ZeniteSolar/Chopper2016/README.md

# Chopper2016
Repositório dedicado ao desenvolvimento do Chopper2016
