ZeniteSolar/Chopper2016/Snubber/A non isolated bidirectional DC-DC converter with LCD snubber.pdf

Rev. Téc. Ing. Univ. Zulia. Vol. 39, Nº 1, 131 - 143, 2016

## A non isolated bidirectional DC-DC converter with LCD snubber

J.Barsana Banu¹

, Dr.M.Balasingh Moses²

and S.Rajarajacholan³
1Research Scholar,EEE Dept, Anna University, Trichy,India. 2Assistant Professor,EEE Dept, Anna University, Trichy, India. 3Teaching Fellow,EEE Dept, University College of Engineering,Ariyalur, India. *Correspondence:barsanajamal@gmail.com

Abstract: This paper proposes a non isolated Bidirectional DC-DC Converter with LCD (Inductance Capacitance Diode) snubber achieves high efficiency. In this paper non dissipative LCD clamp circuit is introduced not only achieves high efficiency, reduces cost, simple structure and also reduces current spike in the conventional NBDC, reduces switching losses and applicable for higher power conversion. The proposed non dissipative LCD snubber recycle the energy absorbed from either input or output side and it circulate through throughout the switching period. The proposed topology is simulated using MATLAB/SIMULINK software and its operation modes for both boost and buck conversion has been investigated
throughout the paper. The simulated results of the proposed converter are compared with the conventional NBDC’s
topologies to verify its effectiveness. The proposed NBDC topology is experimentally verified for a 0.5 KW prototype.
Key words: LCD Snubber, Non isolated bidirectional dc-dc converter (NBDC), soft switching, current spike.

### 1. INTRODUCTION

The Bidirectional DC-DC Converter topologies has raised lot of attention in recent years for the application of many power related system including fuel cell, hybrid electric vehicle ,renewable energy system, Uninterruptable power supplies and so on which needs high efficiency and high power density. The Bidirectional DC-DC Converter transfer power between its input and output power sources by step up or step down the voltage levels depending upon the requirements. Basically bidirectional DC-DC converters can be classified in to Non Isolated bidirectional DC-DC converters and isolated bidirectional DC-DC converters.
In Isolated bidirectional DC-DC converters galvanic isolation is needed between current fed and voltage fed bridges. High frequency isolation transformer provided in the full bridge topologies increases cost and number of switching devices ( Inoue.S et al.,2007, Lizhi Zhu ,2006, and T.Reimann et al.,1997).Dual active bridge isolated bidirectional are proposed to raise the power level with different phase shift control (Huiqing Wen et al.,2015,Krismer F et al.,2009,Mi.C et al.,2008, and R.W. De Doncker et al.,2007).Isolated bidirectional dc-dc converter with RCD snubber,flyback, active clamp and passive clamp methods are also described to improve the conversion ratio ,reduction of voltage spike, limiting voltage and current stresses through the active switches and soft switching achieved (Mohammadjavad Baei et al.,2014,R.Watson et al., 1996, Tsai-Fu-Wu et al.,2010, Tsai-Fu Wu et al.,2011,and Yanbo Che et al.,2014). Sometimes bidirectional power flow between grid and battery is possible (Ho-Sung Kim et al., 2013, and Hua Han et al., 2014).
Due to weight, size, high number of semiconductor devices and power transformer associated in the isolated bidirectional dc-dc converter ,the interest is focused to transformer less non-isolated bidirectional DC-DC converter which is attractive converter topology for improving the efficiency .The basic transformer less non-isolated bidirectional DC-DC converter is the combination of boost and buck converter connected in antiparallel.The comparative evaluation of various NBDC based on their efficiencies and cost consideration have done in (Baburaja.C et al.,2013,and Taewon Kang et al.,2012).In the high power converters to achieve maximum efficiency MOSFETS can be applied instead of IGBT with bidirectional power flow legs which suppress the switching loss occurs due to reverse recovery of the body diode (Hyung-Min Ryu .,2014).
To improve the power rating as well as clamp the diode oscillations of the converter RC-RCD clamp circuit is introduced (Milanovic.M et al.,2006).Optimal design of DC-DC converter employed with genetic algorithm and taguchi method are proposed for spike voltage reduction (Chuan-Kuei Huang et al.,2010).To reduce the ripple current shown in the conventional NBDC multiphase interleaved half bridge topology is introduced (Yanbo Che et al.,2014).Due to the low ripple current and reverse recovery problem in the conventional NBDC, series resonance, parallel resonance, and quasi-resonance methods have progressed to alleviate the above problem (K. H. Liu et al.,1987,and R. Redl et al.,1986).Due to high circulating energy conduction losses are occur in the resonant converter, the zero voltage transition (ZVT) and zero current transition (ZCT) methods are introduced to overcome the problems in the resonant converter (G. Hua et al.,1994).
The ZVT and ZCT methods are that switches turning ON and turning OFF under zero voltage and zero current condition using resonance. Sometimes auxiliary switches are used in addition with main switches to operate the NBDC without switching loss (D.-Y. Lee et al.,2003).Zero Voltage transition PWM NBDC are implemented with coupled inductor to achieve high efficiency at both step up and step down conversion (Ju-Kyoung Eom et al.,2012).Leakage inductance is fully utilized and voltage stress in the switches reduced by providing tapped inductor topology(Amin Mirzaei et al.,2012,and Jeong-il Kang et al.,2014).
Modified PWM based NBDCs with coupled inductor is presented to reduce the converter volume (A.Amalin Rishma et al.,2012).Further soft switching NBDC with LC Series resonant circuit is also proposed to achieve maximum efficiency at all load conditions (Doo-Yong Jung et al.,2013).Soft-switching dc-dc converter with auxiliary switch control is proposed to improve the efficiency of non isolated bidirectional converter with look up table reference (Jung-Hyo Lee et al.,2013) this method brings the more efficient control in both step up and step down mode operation.
In this paper non dissipative LCD clamp circuit is introduced to achieve high efficiency, reduces switching losses and applicable for higher power conversion. This Non dissipative LCD snubber recycle the energy absorbed from either input or output side and it circulate through throughout the switching period. The advantages of the proposed converter are high reliability, simple structure, low cost and high efficiency.

### 2. PROPOSED TOPOLOGY

The proposed non isolated bidirectional dc–dc converter with LCD snubber is shown in Fig.1. The proposed LCD snubber circuit consists of Resonant inductor Lr, Resonant Capacitors Cr1 and Cr2 , and two Diodes D1 and D2 in addition with basic bidirectional converter topology. RCD snubber is a dissipative one which dissipate large amount of energy stored in the capacitor through the snubber resistance. Hence it increases the component sizes and creates a heat transfer problems. The proposed non dissipative LCD clamp with passive components eliminates the above problems by storing the leakage energy in to a capacitor even the semiconductor device is in OFF conditions. The proposed converter reduces switching losses with the help of soft switching. The proposed converter is categorized in to two modes: boost mode conversion (step up) and buck mode conversion (step down) based on the current flowing through each component in a proposed circuit and voltage across the switches.

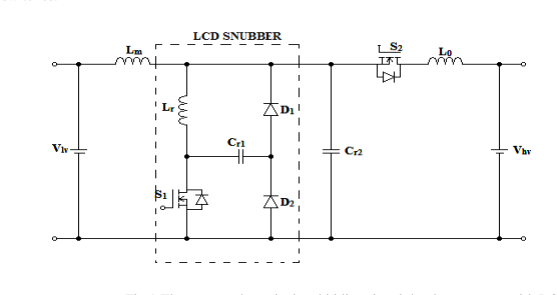
[picture p9: figure]

Fig.1.The proposed non isolated bidirectional dc–dc converter with LCD snubber

Fig.1 consists of main inductor Lm, two main switches S1 and S2 are operated under soft switching. The output inductor L0 perform filtering when energy flows from the input side (low voltage side) to the batteries (high voltage side), which is denoted as a boost mode and vice versa operation takes place in buck mode when power flows from the batteries(high voltage side) to the low voltage side. The resonance of the proposed converter is caused by the main inductor Lm and snubber capacitors Cr1 and Cr2. The proposed LCD clamp recycle the energy absorbed from either input or output side and it circulate through throughout the switching period and soft switching can be achieved .
A non isolated bidirectional dc-dc converter with LCD clamp has two types of conversion: boost mode conversion (step up) and buck mode conversion (step down).In boost mode switch S1 controlled and body diode of S2 provide a current path to the load. In buck mode switch S2 controlled and body diode of S1 provide a current path to the load. To intend the converter design, theoretical investigation must be indomitable. The main aim of the steady state analysis is to obtain derivations and equations for various devices used in the proposed bidirectional LCD clamp circuit.The assumptions are
1) Main inductor Lm is considered large enough
2) All devices are ideal
3) All the elements have zero voltage drops.
In boost mode switch S1 is operated, body diode of switch S2 will conduct to transfer power from low voltage side to high voltage side. In this mode snubber capacitor Cs makes the switchS1 to turn OFF under ZVS.The operation mode of proposed topology in boost mode is divided in to eight modes. Fig. 2 shows the various operation mode of the proposed converter in step up conversion during a switching period.
Mode 1 [ t0 ≤ t < t1 ]: At time t0 switches S1 and S2 are in off state .The input dc voltage is directly connected to the load through main inductor current iLm and antiparallel diode of switch S2. Here the voltage across Lm is negative. Hence iLm decreases linearly.

iLm t0

=

Vlv −Vhv
Lm

t −t0

+ I0

(1)
iLm t1
= I1 = Imin | (2)
iLr

t0

= 0 | (3)
VCr1
t = 0 | (4)
VCr2
t = Vhv = Vco | (5)

Mode 2 [ t1 ≤ t < t2 ]: Mode 1 starts when the switch S1 is turned ON by ZCS because of Lr

.output voltage is
supplied via resonant inductor, thus iLr

starts increasing. The current through the antiparallel diode of switch S2 becomes zero when iLr = iLm
iLm t =

Vlv −Vhv
Lm
t + Imin | (6)
iLm t2
= I1 = Imin | (7)
iLr

t2

= I1

(8)
VCr1
t = 0 | (9)
VCr2
t = Vhv = Vco | (10)

Mode 3 [ t2 ≤ t < t3 ]: This mode is started when current through the antiparallel diode of switch S2 becomes zero. In this mode main inductor current iLm flows through Lr and switch S1.the resonant inductor Lr and the resonant capacitor Cr2 starts resonate, therefore VCr2 starts decreases from output voltage to zero.
iLm t3
= I1 = Imin | (11)
iLr

t = I1 +

Vhv
Lr
t | (12)
iLr

t3

= I2

(13)
VCr1
t = 0 | (14)
VCr2

t = Vco cosωr

t | (15)
ωr =

1
CrLr

(16)

Cr = Cr1 + Cr2

(17)
VCr2

t3

= 0 | (18)

Mode 4 [ t3 ≤ t < t4 ]: This mode begins at VCr2 =0 and the snubber diodes D1 and D2 are turned on. iLm t =

Vlv
Lm

t + I2

(19)

iLm t4

=

Vlv
Lm

t +I2

(20)

iLr

t4

= Imin +

VC 0
Zr

(21)
VCr1
t = 0 | (22)
VCr2
t = 0 | (23)

Mode 5 [ t4 ≤ t < t5 ]: At time t4 ,the switch S1is turned OFF with ZVS condition because of resonant capacitor Vcr1.the proposed circuit serves two current loops in this mode .
i) Lm-Cr2-VLV, VCr2 increases from zero to output voltage
ii) Lr-Cr1- D1, loop for second resonance,energy stored in resonant inductor shifts to Cr1,therefore iLr starts decreasing and VCr1 becomes high value.
iLm t5

= I3

(24)
iLr

t5

= I2 cos ωr

t | (25)

VCr1

t =

Lr
Cr

I2 sinωr1

t | (26)

ωr1 =

1

Cr1Lr

(27)

VCr2

t =

I3

Cr1

(28)
VCr2

t5

= Vhv = Vc0

(29)

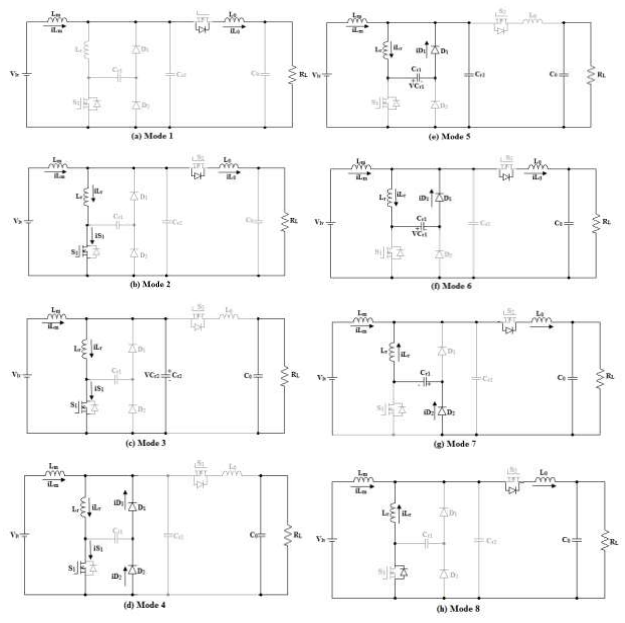
[picture p10: figure]

Fig.2.Operation modes of boost mode conversion (a) Mode 1 (b) Mode 2 (c) Mode 3 (d) Mode 4
(e) Mode 5 (f) Mode 6 (g) Mode 7 (h) Mode 8.

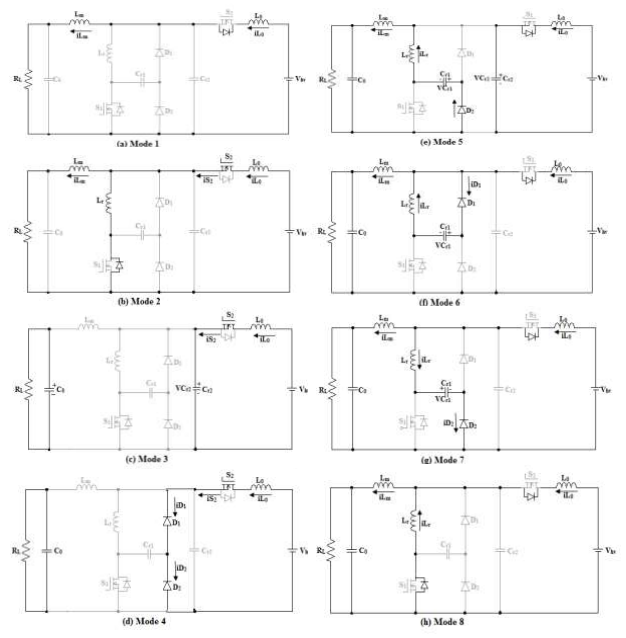
[picture p11: figure]

Fig.3.Operation modes of buck mode conversion (a) Mode 1 (b) Mode 2 (c) Mode 3 (d) Mode 4
(e) Mode 5 (f) Mode 6 (g) Mode 7 (h) Mode 8.

Mode 6 [ t5 ≤ t < t6 ]: This mode starts at VCr1 =V0 and iLr =0 because of energy stored in resonant inductor is totally discharged to VCr1.
iLm t5
= I4 = Imax | (30)
iLr

t6

= 0 | (31)

VCr1

t =

Lr
Cr

I2 cos ωr1

t | (32)

VCr1

t6

= 0 | (33)
VCr2
t = Vhv = Vc0 | (34)

Mode 7 [ t6 ≤ t < t7 ]:In this mode VCr1 starts resonate and decreases through D2 - Cr1- Lr-Ds2- C0 untilVCr1 =0 ,the energy absorbed in Cr1discharges to resonant inductor Lr

.when VCr1 =0, iLr changes its current direction,then antiparallel diode of switch S2 turns on.
iLm t =
Vlv −Vhv Lm t + I4 | (35)

iLm t7

= I5

(36)
iLr

t = I2 sinωr

t | (37)
iLr

t7

= 0 | (38)

VCr1

t = Vc0 −

Lr
Cr

I2 cosωr1

t | (39)

VCr1

t7

= 0 | (40)
VCr2
t = Vc0 | (41)

Mode 8 [ t7 ≤ t < t8 ]: This mode begins at VCr1 =0.It has two current paths.The main inductor current flows to the load through antiparallel diode of switch S2 as well as resonant inductor current shifts to the load through
Ds1 and Ds2.This mode ends at iLr reaches to zero. iLm t8 = I6 | (42)

iLr

t = I5 −

Vc0
Lr
t | (43)
iLr

t8

= 0 | (44)
VCr1
t = 0 | (45)
VCr2
t = Vhv = Vc0 | (46)

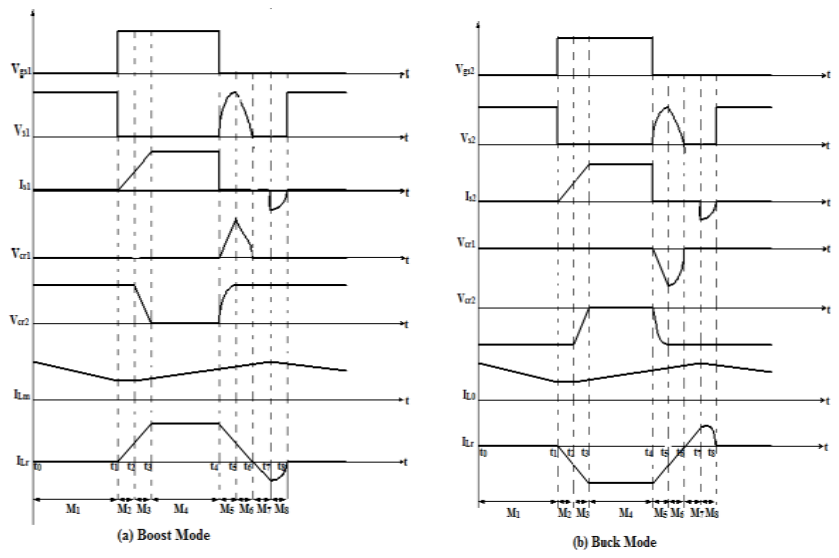
[picture p12: figure]

Fig.4.Key waveforms (a) Boost Mode (b) Buck Mode

Fig.3 shows the operation mode of the proposed converter in step down conversion during a switching period. Key waveforms for boost mode and buck mode is described in Fig.4.In buck mode switch S2 is operated and body diode of switch S1 will conduct to transfer power from high voltage side to batteries (low voltage side). In this mode snubber capacitor Cs makes the switch S2 to turn OFF under ZVS.The operation mode of proposed topology in buck mode is analogous to the boost mode and also divided in to eight modes as indicated in fig 3 because it operates in inverse with boost mode.

### 3. RESULTS AND DISCUSSIONS

In order to verify the feasibility of the proposed LCD snubber topology. A 0.5 KW converter prototype was built and implemented. MATLAB/SIMULINK software is used to simulate the proposed non isolated bidirectional dc-dc converter with LCD clamp circuit to verify its effectiveness for both buck and boost modes. The switching current and voltages waveforms are measured to ensure the converter is operated in soft switching condition. Fig.5 shows the 0.5 KW prototype of the proposed NBDC with LCD clamp,it should be

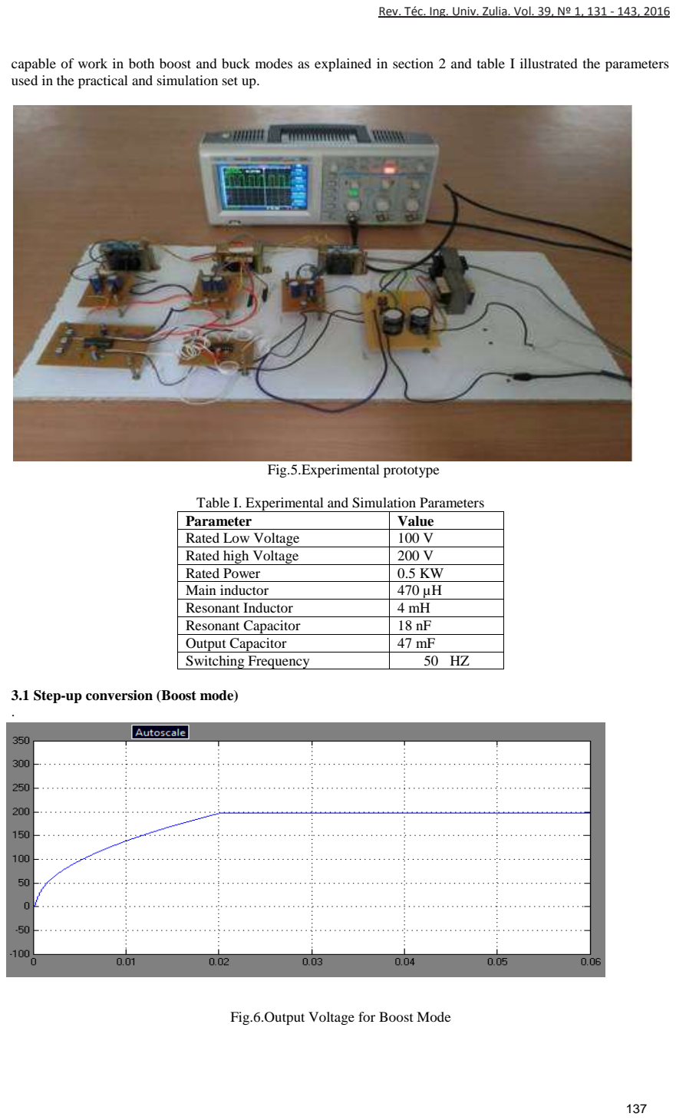
[picture p13: page 7]

capable of work in both boost and buck modes as explained in section 2 and table I illustrated the parameters used in the practical and simulation set up.

Fig.5.Experimental prototype

Table I. Experimental and Simulation Parameters
Parameter | Value
Rated Low Voltage | 100 V
Rated high Voltage | 200 V
Rated Power | 0.5 KW
Main inductor | 470 µH
Resonant Inductor | 4 mH
Resonant Capacitor | 18 nF
Output Capacitor | 47 mF
Switching Frequency | 50 HZ

### 3.1 Step-up conversion (Boost mode)

Fig.6.Output Voltage for Boost Mode

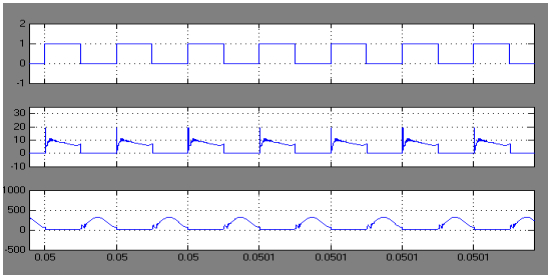
[picture p14: figure]

Fig.7.Triggering pulse, current through and voltage across switch S1

Fig.6 shows the simulated output voltage for boost (200 V) mode with the dc input voltage of 100 V. The gate pulse, current flowing through and voltage across the terminals for switch S1 of the proposed topology is obtained in Fig.7 for step up and 200 V dc for step down conversion. From the above waveforms it is clearly states the switch S1 is operated under zero voltage condition, it is turned ON and OFF at zero voltage ripple current also reduces, and therefore current through the inductor is continuous.

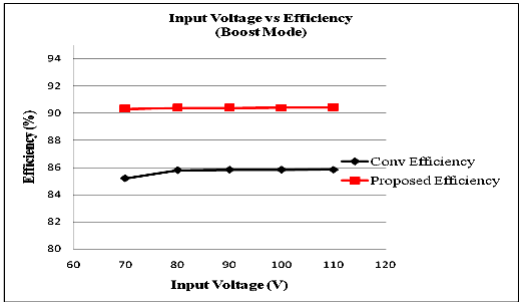
[picture p15: figure]

Fig.8.Efficiency Comparision of boost mode

138

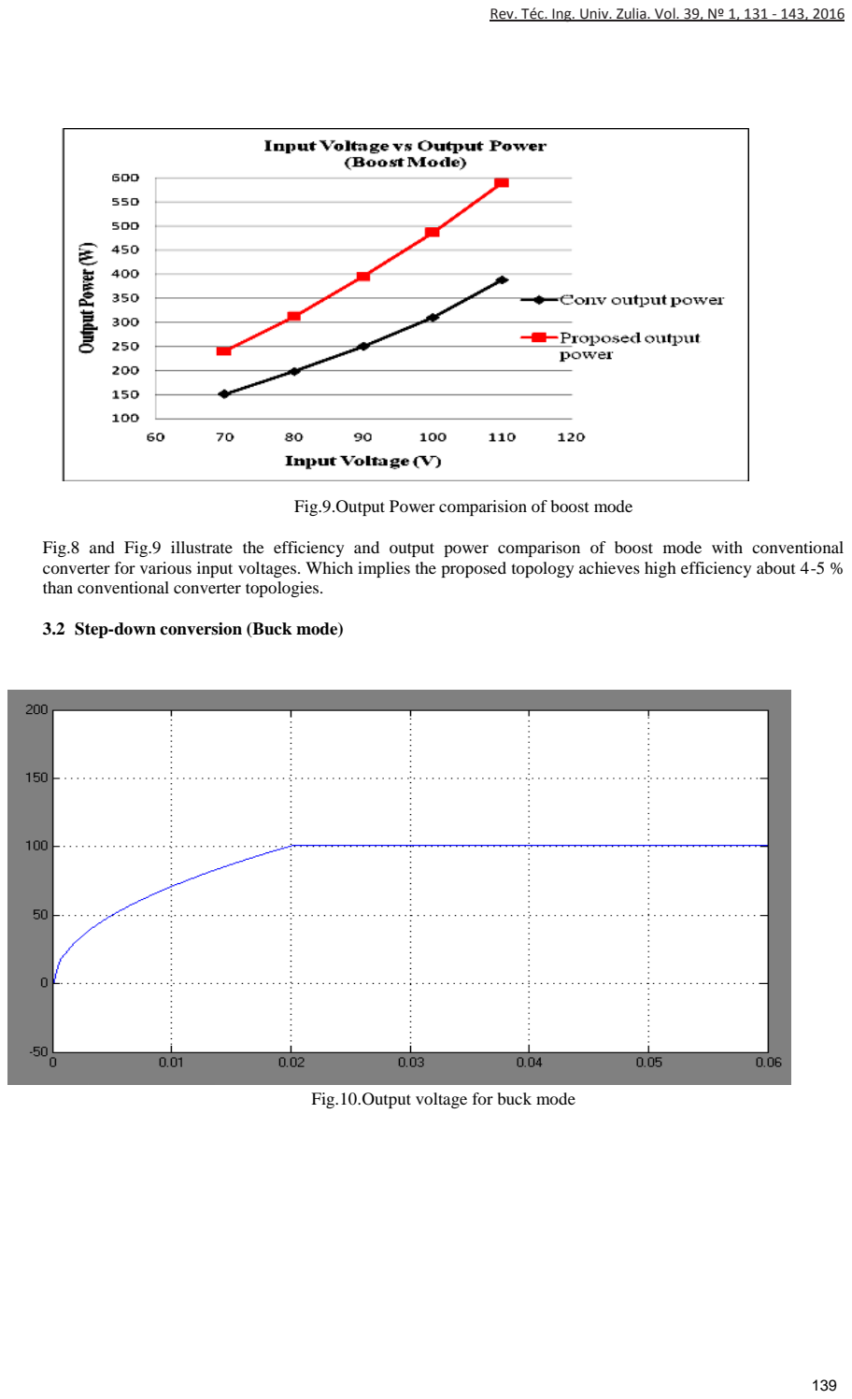
[picture p16: page 9]

Fig.9.Output Power comparision of boost mode

Fig.8 and Fig.9 illustrate the efficiency and output power comparison of boost mode with conventional converter for various input voltages. Which implies the proposed topology achieves high efficiency about 4-5 % than conventional converter topologies.

### 3.2 Step-down conversion (Buck mode)

Fig.10.Output voltage for buck mode

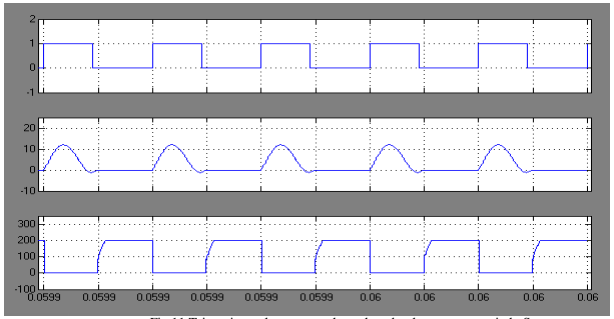
[picture p17: figure]

Fig.11.Triggering pulse, current through and voltage across switch S2

Fig.10 shows the simulated output voltage for buck (100 V) mode. Fig.11 shows the gate pulse, current through and voltage across waveforms for switch S2 of the proposed NBDC when the input voltage is 200 V dc for step down conversion. From the above waveforms it is obviously the switches are operated under zero voltage condition during buck mode, ripple current also reduces, and therefore current through the inductor is continuous as same as boost mode.

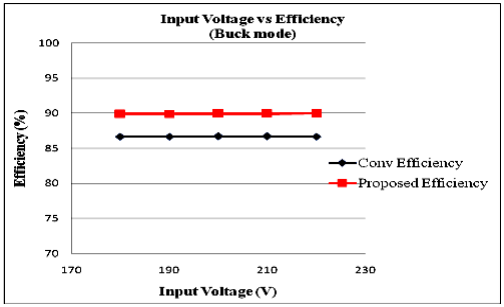
[picture p18: figure]

Fig.12.Efficiency Comparision of buck mode

140

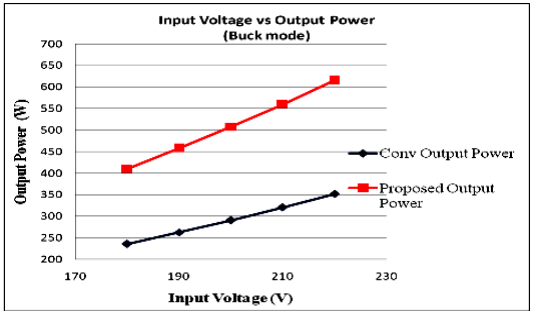
[picture p19: figure]

Fig.13.Output Power Comparison of buck mode

The efficiency and output power comparison of buck mode is done in Fig.12 and Fig.13.which also states that the proposed topology achieves high efficiency than conventional NBDC.

Table II. Efficiency comparison of the proposed converter operation
Switching | Boost mode | Buck mode
Input voltage(V) | Output power(W) | Efficiency (%η) | Input voltage(V) | Output power(W) | Efficiency (%η)
Hard | 70 | 151 | 85.2 | 180 | 236 | 86.67
Soft | | 240 | 90.3 | | 410 | 89.89
Hard | 80 | 198 | 85.79 | 190 | 263 | 86.68
Soft | | 312 | 90.37 | | 458 | 89.91
Hard | 90 | 250 | 85.42 | 200 | 291 | 86.7
Soft | | 395 | 90.38 | | 508 | 89.93
Hard | 100 | 310 | 85.83 | 210 | 321 | 86.72
Soft | | 487 | 90.39 | | 560 | 89.94
Hard | 110 | 388 | 85.84 | 220 | 352 | 86.69
Soft | | 580 | 90.41 | | 616 | 89.96

Table II indicate the output power and efficiency comparison of conventional hard switching NBDC and proposed NBDC with LCD clamp. The proposed circuit achieves high efficiency for the same input voltage applied at all modes.

### 4. CONCLUSIONS

This paper presents a non isolated bidirectional dc-dc converter with LCD clamp circuit that is specifically used for battery applications that require a maximum efficiency is proposed in this paper for step up and step down conversion. The proposed Non dissipative LCD snubber recycle the energy absorbed from either input or output side and it circulate through throughout the switching period as well as reduces the current ripple and switching losses with proper operation of the switches. Soft switching capability is achieved at all operating modes. The validity of the proposed topology is experimentally verified.

References
A.Amalin Rishma,P.Raja Rajeswari,M.Sasikumar, “High Efficiency Modified Pulse | Width | Modulation
Bidirectional Converters for Medium Power Drives,”IJAIEM, vol. 1, no. 2, pp. 94–100, 2012.

Amin Mirzaei,Awang jusoh,Zainal Salam, “Design and Implementation of High Efficiency | Non | Isolated
Bidirectional Zero Voltage Transition Pulse With | modulated | DC-DC | converters,” | 2012,
Elsevier,Energy 47, pp. 358–369.
Baburaja.C | and | J.Jayakumar, | “Transformer | less | soft | switching | bi-directional | DC-DC
Chopper”,International journal of Engineering and Advanced Technology, 2013, | vol. 2, pp.
391-395.
Chuan-Kuei Huang,Hsiau-Hsian Nien,Koan-Yuh Chang and Wen-Jer Chang,,“An | Optimal | Designed
RCD Snubber for DC-DC Converters,”Journal of Marine | Science and Technology, Vol. 18, No. 6,
pp. 901-906, 2010
D.-Y. Lee, M.-K. Kee, D.-S. Hyun, and I. Choy, “New zero-current-transition PWM | DC/DC | converters
without Current Stress,” IEEE Trans. Power Electron., 2003,vol. 18, no. 1, pp. 95–104.
Doo-Yong Jung, Sun-Hee Hwang, Young-Hyok Ji, Jung-Hyo Lee, Yong-Chae Jung and Chung-Yuen | Won,
“Soft-Switching Bidirectional dc-dc Converter with a LC | Series Resonant Circuit,” IEEE Trans.
Power Electron ,vol. 28, no. 4, pp. 1680– | 1690,2013.
G. Hua, C. Leu, Y. Jiang, and F. C. Lee, “Novel zero-voltage transition PWM converters,” | IEEE | Trans.
Power Electron., vol. 9, no. 2, pp. 213– 219, Mar. | 1994.
Ho-Sung Kim,Myung-Hyo Ryu,Ju-Won Back and Jee-Hoon Jung, “High-Efficiency | Isolated Bidirectional
AC-DC Converter for a dc Distribution System,” IEEE Trans.Power Electron., 2013, vol. 28, no. 4, pp. 1642–1654.
Hua Han,Yonglu Liu,Yao Sun,Hui Wang and Mei Su, “A Single Phase Current Source Bidirectional Converter for V2G Applications” Journal of Power Electronics, 2014,vol. 14, no. 3, pp. 458-467.
Huiqing Wen and BinSu, “Reactive Power and Soft-Switching Capability Analysis of | Dual -Active –Bridge
DC-DC Converters with Dual-Phase-Shift Control” | Journal of Power Electronics, vol. 15, no. 1, pp.
18–30, 2015
Hyung-Min Ryu , “High Efficient High-Volatge MOSFET Converter with Bidirectional Power Flow Legs”,
Journal of Power Electronics, Vol. 14, No. 2, pp. 265-270, | 2014.
Inoue S. & Akagi.H ,“A Bidirectional dc-dc Converter for an Energy Storage System | with | Galvanic
Isolation,” IEEE Trans. Power Electron., 2007, vol. 22, no. 6, pp. | 2299-2306.
Jeong-il Kang,Sang-Kyoo Han and Jonghee Han, “Lossless Snubber with Minimum | Voltage Stress for
continiousCurrent Mode Tapped-Inductor Boost Converters | for | High | Step-up | Applications,”
2014,Journal of Power Electronics, vol. 18, no. | 4, pp. 621–631.
Ju-Kyoung Eom,Jun-Gu Kim,Jae-Hyung Kim,Soon-Tack oh, “Analysis of a Novel Soft Switching Bidirectional DC-Dc converter,” 2012, vol. 12, no. 6, pp. 859–868.
Jung-Hyo Lee,Dong-Ho Yu,Jun-Gu Kim & Young-Ho Kim,“Auxiliary Switch Control of a Bidirectional SoftSwitching dc-dc Converter,” IEEE Trans. Power Electron, vol. 28, no. 12, pp. 5446–5457, Dec 2013.
K. H. Liu, R. Oruganti, and F. C. Lee,“Quasi-resonant converters-topologies and | characteristics,” IEEE
Trans. Power Electron.,vol. PE-2, no. 1, pp. 62–71,1987.
Krismer F and J. W. Kolar, “Accurate small-signal model for the digital control of an | automotive
bidirectional dual active bridge,” IEEE Trans.Power Electron., 2009, | vol. 24, no.12, pp. 2756–2768.
Lizhi Zhu, “A Novel Soft-Commutating Isolated Boost Full Bridge ZVS PWM dc–dc | Converter | for
Bidirectional High Power Applications,” IEEE Trans.Power | Electron, 2006,vol. 21, no.2, pp. 422-
429.
Mi.C,Bai.H,Wang.C and Gargies.S, “Design and control of dual H-bridge based isolated bidirectional DC-DC
Converter,” IEEE Trans. Power Electron, 2008,vol.1, no 4, pp. 507–517
Milanovic.M,Korelic.J,Hren.A,Mihalic.F and Slibar.P,“ Reduction of Ringing Losses in Flyback Converter by
Using the RC-RCD Clamp Circuit”AUTOMATIKA 47 , | 2006,vol. 1, no. 2, pp. 31-37.
Mohammadjavad Baei, Mehdi Narimani and Gerry Moschopoulos,“A New ZVS-PWM Full-Bridge | Boost
Converter,” Journal of Power Electronics, 2014, Vol. 14, No. | 2, pp. 237-248.
R. Redl, B. Molnar, and N. O. Sokal, “Class E resonant regulated dc/dc power | converters: | Analysis | of
operation and experimental results at 1.5 MHz,” IEEE Trans.Power Electron., 1986,Vol. PE-1, no. 2, pp. 111–120.
R.W. De Doncker, D. M. Divan, and M. H. Kheraluwala, “Power conversion apparatus for dc-dc conversion
using dual active bridges,” OS. Patent No. 5,027,261, 2007.
R.Watson. and F. C. Lee,“A Soft Switched Full Bridge Boost Converter Employing an | Active | Clamp
Circuit,” lEEE Power Electron. Spec. Conf.proc , 1996, vol.2,pp. | 1948-1954.
T. Reimann, S. Szeponik, and G. Berger, “A novel control principle of bi-directional | DC-DC | Power
Conversion,” in Proc. Power Electron. Spec.Conf, 1997, vol. 2, pp. 978–984.
Taewon Kang,Changwoo kim and Yongsug Suh,“A Design and control of Bidirectional Non isolated DC-DC
converter for Rapid Electric Vehicle Charging System”, | 2012, pp. 14–21

Tsai-Fu Wu, Jeng-Gung Yang , Chia-Ling Kuo , Kun-Han Sun , Yu-Kai Chen, “Comparison of Bi-directional Isolated full-bridge Converters with Combinations of Active and Passive Snubbers,” 2011,Proc. IEEE
Power | Electron. Spec. Conf.Proc,pp.127-133.
Tsai-Fu-Wu,Yung-chu chen, Jeng-Gung Yang, Chia-Ling Kuo,“Isolated Bidirectional | Full Bridge dc–dc
Converter with a Flyback Snubber,” IEEE Trans.Power | Electron, | vol.25,no. | 7,pp.1915 | –
1922,2010.
Yanbo Che,Yaga Ma,Shaoyun Ge and Dong Zhu,“Digital Control of Secondary Active Clamp Phase-Shifted Full bridge Converters,” Journal of Power Electronics, 2014, vol. 14, no. 3, pp. 421–431

143
