ZeniteSolar/Chopper2016/relatórios/primeiro_teste_24v/ALL0000/F0000CH2.CSV

Record Length | 2.500000e+03 | -0.002500000000 | 14.80000
Sample Interval | 2.000000e-06 | -0.002498000000 | 15.20000
Trigger Point | 1.250000000000e+03 | -0.002496000000 | 14.80000
 |  | -0.002494000000 | 14.80000
 |  | -0.002492000000 | 14.80000
 |  | -0.002490000000 | 14.80000
Source | CH2 | -0.002488000000 | 14.80000
Vertical Units | V | -0.002486000000 | 14.80000
Vertical Scale | 1.000000e+01 | -0.002484000000 | 14.80000
Vertical Offset | -3.000000e+01 | -0.002482000000 | 15.20000
Horizontal Units | s | -0.002480000000 | 14.80000
Horizontal Scale | 5.000000e-04 | -0.002478000000 | 14.80000
Pt Fmt | Y | -0.002476000000 | 14.80000
Yzero | 0.000000e+00 | -0.002474000000 | 14.80000
Probe Atten | 1.000000e+01 | -0.002472000000 | 14.80000
Model Number | TDS1012C-EDU | -0.002470000000 | 14.80000
Serial Number | C013516 | -0.002468000000 | 14.80000
Firmware Version | FV:v25.07 | -0.002466000000 | 14.80000
 |  | -00.002464000000 | 14.80000
 |  | -00.002462000000 | 14.80000
 |  | -00.002460000000 | 14.80000
 |  | -00.002458000000 | 14.80000
 |  | -00.002456000000 | 14.80000
 |  | -00.002454000000 | 14.80000
 |  | -00.002452000000 | 14.80000
 |  | -00.002450000000 | 15.20000
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
