ZeniteSolar/Chopper2016/relatórios/primeiro_teste_24v/ALL0002/F0002CH1.CSV

Record Length | 2.500000e+03 | -0.000012500000 | 2.08000
Sample Interval | 1.000000e-08 | -0.000012490000 | 2.08000
Trigger Point | 1.250000000000e+03 | -0.000012480000 | 2.08000
 |  | -0.000012470000 | 2.08000
 |  | -0.000012460000 | 2.08000
 |  | -0.000012450000 | 2.08000
Source | CH1 | -0.000012440000 | 2.08000
Vertical Units | V | -0.000012430000 | 2.08000
Vertical Scale | 5.000000e-01 | -0.000012420000 | 2.08000
Vertical Offset | -9.600000e-01 | -0.000012410000 | 2.08000
Horizontal Units | s | -0.000012400000 | 2.08000
Horizontal Scale | 2.500000e-06 | -0.000012390000 | 2.08000
Pt Fmt | Y | -0.000012380000 | 2.08000
Yzero | 0.000000e+00 | -0.000012370000 | 2.08000
Probe Atten | 1.000000e+01 | -0.000012360000 | 2.08000
Model Number | TDS1012C-EDU | -0.000012350000 | 2.08000
Serial Number | C013516 | -0.000012340000 | 2.08000
Firmware Version | FV:v25.07 | -0.000012330000 | 2.08000
 |  | -00.000012320000 | 2.08000
 |  | -00.000012310000 | 2.08000
 |  | -00.000012300000 | 2.08000
 |  | -00.000012290000 | 2.08000
 |  | -00.000012280000 | 2.08000
 |  | -00.000012270000 | 2.08000
 |  | -00.000012260000 | 2.08000
 |  | -00.000012250000 | 2.08000
 |  | -00.000012240000 | 2.08000
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
