ZeniteSolar/Chopper2016/relatórios/primeiro_teste_24v/ALL0003/F0003CH1.CSV

Record Length | 2.500000e+03 | -0.000005000000 | 0.80000
Sample Interval | 1.000000e-08 | -0.000004990000 | 0.80000
Trigger Point | 5.000000000000e+02 | -0.000004980000 | 0.80000
 |  | -0.000004970000 | 0.80000
 |  | -0.000004960000 | 0.80000
 |  | -0.000004950000 | 0.80000
Source | CH1 | -0.000004940000 | 0.40000
Vertical Units | V | -0.000004930000 | 0.80000
Vertical Scale | 1.000000e+01 | -0.000004920000 | 0.80000
Vertical Offset | -1.920000e+01 | -0.000004910000 | 0.40000
Horizontal Units | s | -0.000004900000 | 0.80000
Horizontal Scale | 2.500000e-06 | -0.000004890000 | 0.80000
Pt Fmt | Y | -0.000004880000 | 0.80000
Yzero | 0.000000e+00 | -0.000004870000 | 0.80000
Probe Atten | 1.000000e+01 | -0.000004860000 | 0.80000
Model Number | TDS1012C-EDU | -0.000004850000 | 0.80000
Serial Number | C013516 | -0.000004840000 | 0.80000
Firmware Version | FV:v25.07 | -0.000004830000 | 0.80000
 |  | -00.000004820000 | 0.80000
 |  | -00.000004810000 | 0.40000
 |  | -00.000004800000 | 0.40000
 |  | -00.000004790000 | 0.80000
 |  | -00.000004780000 | 0.80000
 |  | -00.000004770000 | 0.80000
 |  | -00.000004760000 | 0.80000
 |  | -00.000004750000 | 0.40000
 |  | -00.000004740000 | 0.80000
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
