ZeniteSolar/Chopper2016/relatórios/primeiro_teste_24v/ALL0003/F0003CH2.CSV

Record Length | 2.500000e+03 | -0.000005000000 | 15.20000
Sample Interval | 1.000000e-08 | -0.000004990000 | 15.20000
Trigger Point | 5.000000000000e+02 | -0.000004980000 | 15.00000
 |  | -0.000004970000 | 15.00000
 |  | -0.000004960000 | 15.20000
 |  | -0.000004950000 | 15.20000
Source | CH2 | -0.000004940000 | 15.00000
Vertical Units | V | -0.000004930000 | 15.20000
Vertical Scale | 5.000000e+00 | -0.000004920000 | 15.00000
Vertical Offset | -1.500000e+01 | -0.000004910000 | 15.20000
Horizontal Units | s | -0.000004900000 | 15.20000
Horizontal Scale | 2.500000e-06 | -0.000004890000 | 15.20000
Pt Fmt | Y | -0.000004880000 | 15.20000
Yzero | 0.000000e+00 | -0.000004870000 | 15.20000
Probe Atten | 1.000000e+01 | -0.000004860000 | 15.20000
Model Number | TDS1012C-EDU | -0.000004850000 | 15.20000
Serial Number | C013516 | -0.000004840000 | 15.20000
Firmware Version | FV:v25.07 | -0.000004830000 | 15.20000
 |  | -00.000004820000 | 15.20000
 |  | -00.000004810000 | 15.20000
 |  | -00.000004800000 | 15.20000
 |  | -00.000004790000 | 15.20000
 |  | -00.000004780000 | 15.20000
 |  | -00.000004770000 | 15.20000
 |  | -00.000004760000 | 15.20000
 |  | -00.000004750000 | 15.20000
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
