ZeniteSolar/Chopper2016/relatórios/primeiro_teste_24v/ALL0001/F0001TEK.JPG

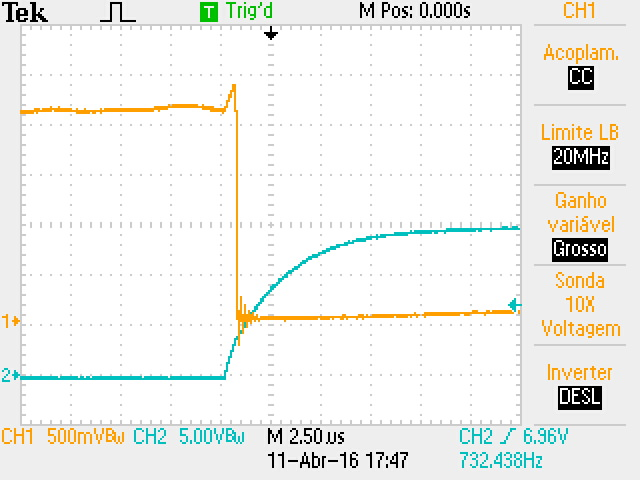
relatórios/primeiro_teste_24v/ALL0001/F0001TEK.JPG
