ZeniteSolar/Chopper2016/relatórios/primeiro_teste_com_carga/TEK0000.JPG

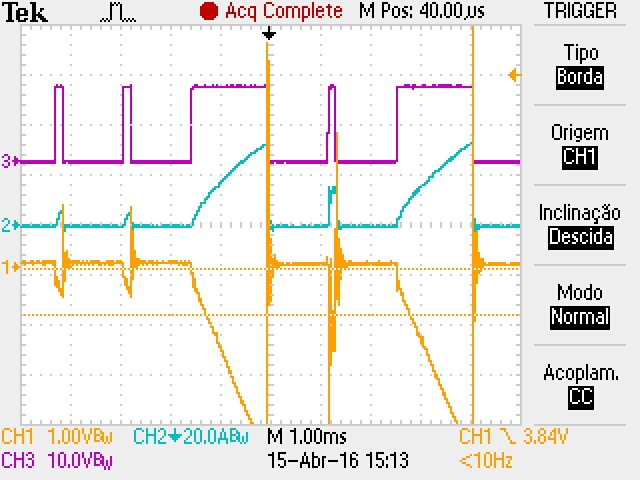
relatórios/primeiro_teste_com_carga/TEK0000.JPG
