ZeniteSolar/Chopper2016/Simulação/LTSPICE/PULSE_LC_.asc

C1: cap; 5480p; Rser=2.3m
L1: ind; 1.66µ
Vin: voltage; PWL(0 0 1u 24)
Named nets: 0, In, out
.tran 0 3u 0 1n
