ZeniteSolar/Chopper2016/Simulação/LTSPICE/SWITCH_LC_.asc

C1: cap; 5480p
C2: cap; 28m; Rser=2 Lser=10n
C3: cap; 5µ2
D1: diode
D2: diode
D3: diode
D4: diode
L1: ind; 38µ
L2: ind; 835n
L3: ind; 835n
L4: ind; 2µ
L7: ind; 20n
L9: ind; 20n
R1: res; 4.8
R2: res; 43m
R3: res; 43m
R4: res; 10
R5: res; 2m
R6: res; 2.3m
R7: res; 2m
S1: sw
V1: voltage; 24
V2: voltage-; 10
Vin: voltage; PULSE(0 10 0 1p 1p .5m 1m)
Named nets: 0, Vds, Vgs, Bat
.tran 0 .7m .49m 10n uic
.model SW SW(Ron=2.3m Roff=1Meg Vt=5)
