ZeniteSolar/Chopper2016/(list of files, drawings)

Other design files:
Hardware/PCB 36V/Chopper PMDC.PcbDoc
Hardware/PCB 36V/Chopper PMDC.PrjPCB
Hardware/PCB 36V/Chopper PMDC.SchDoc
Hardware/PCB 36V/Mosfet_Holes.PcbDoc
Hardware/PCB 36V/PCB1.PcbDoc
Hardware/PCB 36V/PcbLib1.PcbLib
Hardware/PCB 36V/PMDC_power.PcbDoc
Hardware/PCB 36V/Project Outputs for Chopper PMDC/Chopper PMDC.SchDoc
