ZeniteSolar/Chopper2016/Software/placaAdicionalChopper.c

/*
 * Chopper_MPDC_2016.c
 *
 * Created: 18/8/2016 13:25:59
 *  Author: Augusto D. Rodrigues
 *	Equipe Zênite Solar - Projeto Chopper MPDC 2016
 */

//Include header files
#include "bibliotecas/globalDefines.h"
#include "bibliotecas/ATmega328.h"
#include "bibliotecas/can.h"
#include <string.h>
//#include "bibliotecas/can.h"

#define EMA(ma, a, n)	ma += ((a - ma) >> n)
#define EMA_GRADE 1

#define BYTES_TO_RECEIVE 	18 // Number of bytes that uC have to receive on communication

#define SETWORDSIZE 		8  // Number of bits of word to set parameter, used in the comunication with PC
#define GETWORDSIZE 		4  // Number of bits of word to get parameter, used in the comunication with PC

#define INICIODOPACOTE		'@'
#define FINALDOPACOTE		'*'

#define F_CPU 			16000000UL

#define TEMP_CHANNEL	ADC_CHANNEL_0
#define POT_CHANNEL 	ADC_CHANNEL_1 
#define CURRENT_CHANNEL ADC_CHANNEL_2
#define VOLTAGE_CHANNEL ADC_CHANNEL_3

#define TEMP_BIT		PC0
#define POT_BIT 		PC1
#define CURRENT_BIT 	PC2
#define VOLTAGE_BIT 	PC3

#define ON_PIN			PIND
#define ON_PORT			PORTD
#define ON_BIT 			PD5

#define DMS_PIN			PIND
#define DMS_PORT		PORTD
#define DMS_BIT 		PD4

#define FAULT_BIT 		PD3

//definem em qual pino sairá o PWM
#define PWM_DDR 		DDRB
#define PWM_PORT 		PORTB
#define PWM_BIT 		PB1

#define BUZZER_DDR 		DDRC
#define BUZZER_PORT 	PORTC
#define BUZZER_BIT 		PC4

#define LED_DDR 		DDRC
#define LED_PORT 		PORTC
#define LED_BIT 		PC5

//modos de operação, definem quem controla o acionamento
#define CAN_MODE		0
#define SERIAL_MODE		1
#define POT_MODE		2

#define maxCont 		3

#define MAX_FREQ 		1000
#define MIN_FREQ 		500

 #define CAN_ON_BIT		5
 #define CAN_DMS_BIT	6
 #define ID_MI_CHOPPER  0x3000ul//para teste

 // Bit field flags
struct system_flags
{
	uint8 warning		: 1;
	uint8 erro 			: 1;
	uint8 mode			: 2;//modos de operação, definem quem controla o acionamento
	uint8 on			: 1;
	uint8 dms	    	: 1;
	uint8 can_connected	: 1;
	uint8 				: 0;//completa a variavel
};
typedef struct system_flags flags_t;

struct system_status
{
	uint16 freq;				//freq do pwm
	uint16 current;
	uint8 dc;
	uint8 temperature;
	uint16 voltage;
	uint8 on;
};
typedef struct system_status status_t;

flags_t flags;
status_t status;
int16 cont = maxCont;
uint8 cont_can = 60;			//variavel usada para confirmar a conecção can a cada segundo

uint8 channel = TEMP_CHANNEL;	//canal do ad
uint8 maxCurrent = 100;
uint8 minDC = 5;
uint8 dcReq = 0;				//armazena o valor do dc requisitado
uint8 maxDC = 90;
uint8 maxDV = 7;				//define a variação máxima, x V/s				
uint8 maxTemp = 70;				//temperatura maxima, desliga o sistema
uint8 criticalTemp = 60;		//temperatura critica
uint8 minVoltage = 210;			// Este valor é relativo à 10*(tensão de alimentação do sistema) (no momento, 36V)

void seta_dc(uint8 d_cycle)		//função para definição do Duty Cicle do PWM
{
	if(d_cycle < minDC)				// Comparação com o valor mínimo de Duty Cicle
		status.dc = 0;
	else
	{
		if(d_cycle > maxDC)			//Comparação com o valor máximo de Duty Cicle
			status.dc = 100;
		else
		{
			status.dc = d_cycle;
			timer1SetCompareBValue((status.dc * (timer1GetCompareAValue()))/100);		//seta o valor do comparador B para gerar o DC requerido
		}
	}
}

inline void seta_freq(uint16 freqReq)		//função para definição da frequencia do PWM
{
	if(freqReq < MIN_FREQ)
		status.freq = MIN_FREQ;
	else{
		if(freqReq > MAX_FREQ)
			status.freq = MAX_FREQ;
		else
			status.freq = freqReq;
	}
	seta_dc(0);//faz com que o dc va a 0 na mudanca de frequencia
	timer1SetCompareAValue((F_CPU/1024)/status.freq);
	//timer1SetCompareBValue((status.dc * (timer1GetCompareAValue()))/100);//bota o dc
}

//esvazia o buffer de entrada da usart
void esvaziaBuffer()
{
	while(!usartIsReceiverBufferEmpty())
		usartGetDataFromReceiverBuffer();
}

//envia uma msg usando o protocolo GUI
void stringTransmit(char* texto)
{
	uint8 i = 0;
	usartTransmit(INICIODOPACOTE);
	for(i = 0; texto[i] != '\0'; i++)
		usartTransmit(texto[i]);
	usartTransmit(FINALDOPACOTE);
}

//convert uint16 to string of 4 characters
void uint16ToString4(char* str,uint16 value)
{
	str[4] = '\0';
	str[3] = (char ) (value%10 + 48);
	str[2] = (char) ((value%100) / 10 + 48);
	str[1] = (char) ((value%1000) / 100 + 48);
	str[0] = (char) ((value%10000) / 1000 + 48);
}

//convert uint8 to string of 4 characters
void uint8ToString4(char* str,uint16 value)
{
	str[4] = '\0';
	str[3] = (char ) (value%10 + 48);
	str[2] = (char) ((value%100) / 10 + 48);
	str[1] = (char) ((value%1000) / 100 + 48);
	str[0] = '0';
}

//convert string of 4 characters uint16
uint16 string4ToUint16(char* str)
{
	uint16 value;
	value = (uint16) (str[0]-48)*1000 + (str[1]-48)*100 
	+ (str[2]-48)*10 + str[3]-48;
	return value;
}

//convert string of 4 characters uint8
uint8 string4Touint8(char* str)
{
	uint8 value;
	value = (uint8) ((str[1]-48)*100 
	+ (str[2]-48)*10 + str[3]-48);
	return value;
}

int main(void)
{
	flags.mode = POT_MODE;
	status.freq = 1000;
	status.on = 0;			//indica que o sistema inicia sem acionar o motor
	status.dc = 0;
	status.voltage = 0;

	// VARIAVEIS LOCAIS;
	char frameData[50];
	uint8 frameIndex = 0;
	char recebido[100] = "";
	char msgToSend[8] = "";
	uint8 pos =  0;
	
	// CONFIGURA ADC
	clrBit(DDRC,POT_BIT);		//SETA O PINO DO ADC COMO ENTRADA
	clrBit(DDRD,FAULT_BIT);     //SETA O PINO DO FAULT DO DRIVER COMO ENTRADA
	clrBit(PORTD,FAULT_BIT);	//DESABILITA O PULL-UP NO PINO PD3 DO ATmega328
	adcConfig(ADC_MODE_SINGLE_CONVERSION, ADC_REFRENCE_POWER_SUPPLY , ADC_PRESCALER_128);
	adcSelectChannel(POT_CHANNEL);
	adcClearInterruptRequest();
	adcActivateInterrupt();
	adcEnable();
	adcStartConversion();
	
	// CONFIGURA PWM
	timer1Config(TIMER_B_MODE_CTC, TIMER_A_PRESCALER_64);
	timer1ClearCompareBInterruptRequest();									
	timer1ClearCompareAInterruptRequest();
	timer1ActivateCompareBInterrupt();									//ativa a interrupcao do compA
	timer1ActivateCompareAInterrupt();									//ativa a interrupcao do compB
	timer1SetCompareAValue((F_CPU/64)/status.freq);							//valor do comparador A,  define a frequencia
	timer1SetCompareBValue((status.dc * (timer1GetCompareAValue()))/100);		//valor do comparador B,  define Duty Cicle

	// CONFIGURA A INTERRUPÇÃO DE CONTROLE(60Hz)
	timer0Config(TIMER_A_MODE_NORMAL, TIMER_A_PRESCALER_1024);			
	timer0ClearOverflowInterruptRequest();								//limpa a interrupcao de OVF
	timer0ActivateOverflowInterrupt();
						
	// CONFIGURA A USART
	usartConfig(USART_MODE_ASYNCHRONOUS,USART_BAUD_9600 ,USART_DATA_BITS_8,USART_PARITY_NONE,USART_STOP_BIT_SINGLE);
	usartEnableReceiver();
	usartEnableTransmitter();
	usartActivateReceptionCompleteInterrupt();

	// Initializa MCP2515
	can_init(BITRATE_125_KBPS);
	can_set_mode(NORMAL_MODE);

	setBit(PWM_DDR,PWM_BIT);			//define o pino do pwm como saída

	setBit(ON_PORT,ON_BIT);				//habilita o pull-up da chave on
	setBit(DMS_PORT,DMS_BIT);			//habilita o pull-up da chave dms

	setBit(PORTC,POT_BIT);				//habilita o pull-up do potenciometro

	//configura o led e liga ele
	setBit(LED_DDR,LED_BIT);			
	setBit(LED_PORT,LED_BIT);

	//configura o buzzer e da sinal de alerta de ligação
	setBit(BUZZER_DDR,BUZZER_BIT);			
	setBit(BUZZER_PORT,BUZZER_BIT);
	_delay_ms(1000);
	clrBit(BUZZER_PORT,BUZZER_BIT);
	
	sei();

    for(;;)
    {
    	if (can_check_message()){//se chegou uma msg pelo protocolo CAN
    		can_t msg;
    		can_get_message(&msg);
    		if(msg.id == ID_MI_CHOPPER){
    			if(flags.mode != CAN_MODE)
    			{ 
    				status.on = 0;			//reseta o sistema
    				flags.mode = CAN_MODE;
    			}
    			flags.can_connected = 1;
    			flags.dms = msg.data[1] | 1 << CAN_DMS_BIT;
    			flags.on = msg.data[1] | 1 << CAN_ON_BIT;
    			dcReq = (1023 - (((msg.data[1] & 0b00000011 ) << 8) | msg.data[0]))/10;
    			can_send_message(&msg);
    		}
    	}
    	while(!usartIsReceiverBufferEmpty())
    	{
			frameData[frameIndex++] = usartGetDataFromReceiverBuffer();
			if ((frameData[frameIndex-1] == FINALDOPACOTE))
			{//se esta no final da palavra
				if(frameData[0] == INICIODOPACOTE )
				{//verifica se o inicio da palavra esta correto
					strcpy(recebido,frameData);
					pos = (recebido[2]-48) + (recebido[1] - 48)*10;
					if(frameIndex == GETWORDSIZE)
					{
						memcpy( recebido,  (recebido+1), 2);
						recebido[2] = '\0';//isola o id
						switch (pos)
						{
							case 0:
								strcpy(msgToSend,"OK");
								break;
							case 1:
								uint16ToString4(msgToSend,status.freq);
								break;
							case 2:
								uint8ToString4(msgToSend,maxCurrent);
								break;
							case 3:
								uint8ToString4(msgToSend,maxDC);
								break;
							case 4:
								uint8ToString4(msgToSend,minDC);
								break;
							case 5:
								uint8ToString4(msgToSend,maxDV);
								break;
							case 6 :
								if(flags.on)
									strcpy(msgToSend, "0001");
								else
									strcpy(msgToSend, "0000");
								break;
							case 7:
								if(flags.dms)
									strcpy(msgToSend, "0001");
								else
									strcpy(msgToSend, "0000");
								break;
							case 8:
								uint8ToString4(msgToSend,maxTemp);
								break;
							case 9:
								uint8ToString4(msgToSend,minVoltage);
								break;
							case 10:
								uint8ToString4(msgToSend,status.dc);
								break;
							case 11:
								uint8ToString4(msgToSend,status.temperature);
								break;
							case 12:
								uint8ToString4(msgToSend,status.current);
								break;
							case 13:
								uint8ToString4(msgToSend,status.voltage);
								break;
							default:
								strcpy(msgToSend,"ERRO");
						}
						strcat(recebido,msgToSend);
						strcpy(msgToSend,recebido);

						stringTransmit(msgToSend);
					}
					else
					{
						if(frameIndex == SETWORDSIZE)
						{
							if(flags.mode == SERIAL_MODE){
								memcpy((void *) recebido, (void *) (recebido+3), 4);//isola somente o valor, usando 4 caracteres
								recebido[4] = '\0';

								switch (pos)
								{
									case 1:
										seta_freq(string4ToUint16(recebido));
										break;
									case 2:
										maxCurrent = string4Touint8(recebido);
										break;
									case 3:
										maxDC = string4Touint8(recebido);
										break;
									case 4:
										minDC = string4Touint8(recebido);
										seta_dc(dcReq);
										break;
									case 5:
										maxDV = string4Touint8(recebido);
										break;
									case 6 :
										if(recebido[3] == '1')
											flags.on = 1;
										if(recebido[3] == '0')
											flags.on = 0;
										break;
									case 7:
										if(recebido[3] == '1')
											flags.dms = 1;
										if(recebido[3] == '0')
											flags.dms = 0;
										break;
									case 8:
										maxTemp = string4Touint8(recebido);
										break;
									case 9:
										minVoltage = string4Touint8(recebido);
										break;
									case 10:
										//seta_dc(string4Touint8(recebido));
										dcReq = string4Touint8(recebido);
										break;
									case 11:
									case 12:
									case 13:

									default:
										stringTransmit("ERRO");
								}
							}
						}
						else
						{
							stringTransmit("wrong size");	
							esvaziaBuffer();
						}
					}
				}
				else
				{//se o inicio da palavra nao esta correto
					esvaziaBuffer();
				}
				frameIndex = 0;
			}
		}
	}
}

ISR(ADC_vect)
{
	switch (channel)
	{
		case CURRENT_CHANNEL:
			status.current = ADC / 5;
			channel = POT_CHANNEL;
			break;
		case POT_CHANNEL:
			if(flags.mode == POT_MODE)
				dcReq = (1023 / 10) - (ADC/10); 		//logica inversa do pot, para desligar em caso de rompimento do cabo
			channel = VOLTAGE_CHANNEL;
			break;
		case VOLTAGE_CHANNEL:
			EMA(status.voltage,(10*ADC)/21,2);			//calculado apartir da relação de media movel
			channel = TEMP_CHANNEL;
			break;
		case TEMP_CHANNEL:
			status.temperature = ADC / 2;
		default:
			channel = CURRENT_CHANNEL;
			break;
	}
	adcSelectChannel(channel);
	adcStartConversion();
}

ISR(TIMER1_COMPA_vect)
{
	if(status.dc != 0 && status.on)
		setBit(PWM_PORT,PWM_BIT);		//Inicia o período em nível alto do PWM
}

ISR(TIMER1_COMPB_vect)
{
	if(status.dc < 100)
		clrBit(PWM_PORT,PWM_BIT);		//Inicia o período em nível baixo do PWM
}

//controle 60Hz
ISR(TIMER0_OVF_vect)
{
	if(flags.mode == POT_MODE)
	{
		flags.on  = isBitClr(ON_PIN ,ON_BIT );
		flags.dms = isBitClr(DMS_PIN,DMS_BIT);
	}
	else
		if(flags.mode == CAN_MODE){
			if(!--cont_can)//acontece a cada segundo
			{
				cont_can = 60;
				if(flags.can_connected == 0)
				{
					status.on = 0;			//reseta o sistema
					flags.mode = POT_MODE;  
				}
				else
				{
					flags.can_connected = 0;
				}
			}
		}
	if(!(flags.on && !flags.dms))// || status.temperature > maxTemp)//informa ao sistema para nao acionar o motor caso botão ON e DMS estejam desligados.
		status.on = 0;
	else
		if(dcReq < minDC && !status.on)		//informa ao sistema para acionar o motor apenas quando botão ON e DMS estejam ligados
			status.on = 1;					//e o potenciometro esteja numa posicao correspondente a menos de 10% do DC do PWM.
	if(status.on)		//inicia o acionamento do motor, com os as condições preliminares acima satisfeitas.
	{
    	if(status.dc != dcReq)
    	{
    		if(dcReq > status.dc && dcReq > (minDC + 5))//se esta em ascendente
    		{
    			if(!--cont)
    			{
    				cont = maxCont;
    				if(status.dc == 0)
    					seta_dc(minDC);
    				else
    					seta_dc(status.dc+1);
    			}
    		}
    		else
    			if (dcReq < status.dc)
    				seta_dc(dcReq);			//definição do Duty Cicle do PWM
    	}
	}
	else
	{
		if(status.dc != 0)					//se o sistema ainda nao esta desligado
			seta_dc(0);						//desliga o sistema
	}
	if(status.dc >= minDC && (status.current > maxCurrent || status.voltage < minVoltage))
	{
		if(status.dc == 100)
			seta_dc(maxDC);
		else
			seta_dc(status.dc-3);
	}
	/*
	if(status.temperature > criticalTemp && !flags.warning)
	{
		flags.warning = 1;
		//setBit(BUZZER_PORT,BUZZER_BIT);
	}
	else
		if(status.temperature < criticalTemp && flags.warning)
		{
			flags.warning = 0;
			//clrBit(BUZZER_PORT,BUZZER_BIT);
		}
	*/
}

ISR(USART_RX_vect)
{
	usartAddDataToReceiverBuffer(UDR0);
}
