ZeniteSolar/Chopper2016/(commit log)

2016-08-24 adicionando os arquivos necessarios para os primeiros testes do Software
    [placaAdicionalChopper.DSN]
2016-08-24 adicionando a placa de controle
    [Chopper PMDC.GBL, Chopper PMDC.GBO, Chopper PMDC.GBP, Chopper PMDC.GBS, Chopper PMDC.GM1, Chopper PMDC.GTL, Chopper PMDC.GTO, Chopper PMDC.GTS]
2016-08-25 adicionado a conversão dos valores para os sensores existentes na placa
2016-08-25 adicionado as chaves on e dms
    [placaAdicionalChopper.DSN]
2016-08-25 adicionado chaves on/dms na simulação do Proteus
    [placaAdicionalChopper.DSN]
2016-08-25 adicionado o controle na variação ascendente do PWM
    [placaAdicionalChopper.DSN]
2016-08-26 versao utilizada para o primeiro teste no LPEE
    [placaAdicionalChopper.DSN]
2016-08-27 adicionado um sistema de flags
    [placaAdicionalChopper.DSN]
2016-08-28 Na placa, foi adicionado um pino que da acesso ao reset do uC para podermos gravar ele na placa
    [PCB1.PcbDoc]
2016-08-29 Hardware folder cleaned.
    [PCB1.~(129).PcbDoc]
2016-08-30 modificado a parte responsavel pela comunicação com o GUI
    [Chopper PMDC.PrjPCB, PCB1.PcbDoc]
2016-08-31 incluido cabecalho da biblioteca do can e adicionado delay de 1s para estabilizacao das tensões
2016-09-01 alterada a função seta_dc para que esta nao altere o valor de dcReq, assim esta variavel nao necessita ser atualizada a toda hora pela interface com o usuario
2016-09-01 commit necessario para simulacao de teste
2016-09-01 controle de religamento adicionado com sucesso
2016-09-02 implementado controle de corrente com sucesso e compatível com o controle de religamento
2016-09-02 adicionado controle de tensão com sucesso, compatível com os outros controles
2016-09-02 adicionado controle de tensão
2016-09-03 corrigido os pinos dos sensores no firmware de acordo com o hardware
    [placaAdicionalChopper.c]
2016-09-03 comentada algumas linhas para teste
2016-09-05 substituido arquivo de simulacao DSN com os 4 controles do PWM
    [placaAdicionalChopper.DSN]
2016-09-05 feitas algumas otimizaçoes
    [placaAdicionalChopper.DSN]
2016-09-05 corrigido ADCs channels e pinos dos sensores
    [placaAdicionalChopper.c]
2016-09-06 implementada lógica inversa no controle do PWM pelo potenciometro
2016-09-09 comentario sobre a escolha do valor de tensao minima de controle
2016-09-26 correcoes do firmware:inversao DMS, media movel e Vmin = 21V
2016-09-27 adicoinado o pull-up da potenciometro, necessario para garantir que o sistema desligue se o cabo do potenciometro romper.
2016-09-28 commit necessario para realizar pull
2016-10-10 Aumentado os pads da placa e diminuido os furos.
    [Chopper PMDC.PrjPCB, PCB1.PcbDoc]
2016-10-10 Adicionado a sinalização por led.
2016-10-10 Adicionado o led de sinalização.
